jayvala5555/Robocon-2023/README.md

# Robocon-2023
This repositary contains all files and codes related to Robocon project. Robocon is competition organized by ABU Robocon. The ABU Asia-Pacific Robot 
Contest (ABU Robocon) is an Asian-Oceanian college robot competition. In the competition robots compete to complete a task within a set period of time. The theme of
 game was based on Casting Flowers over Angkor Wat.

[`Robocon 2023 Robots Videos`](https://drive.google.com/drive/folders/14jfbaBsFJ9-zaIMvzkVm-kArpuYktAGE?usp=sharing)

[`Robocon 2023 Certificate`](https://drive.google.com/file/d/1AZVT5h_39917kZ-jQ-4AHFau4hDDgrHa/view?usp=sharing)
